Git-Junsang/SpikeSense-Edge/documents/papers/diagrams/fig1_pipeline.png

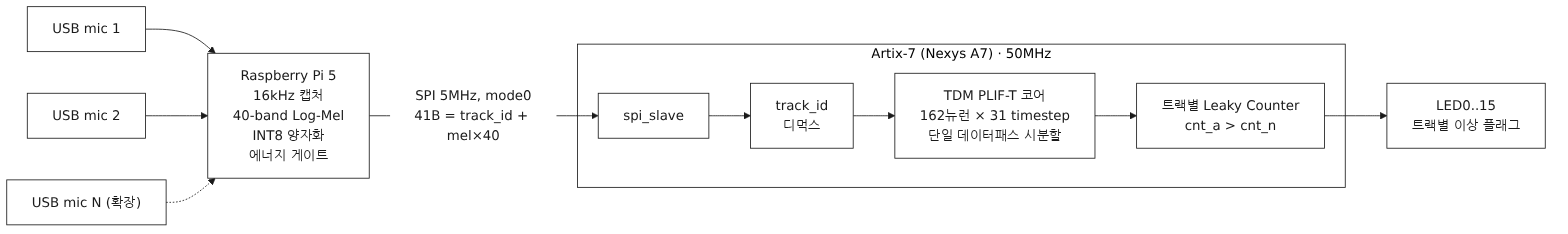
documents/papers/diagrams/fig1_pipeline.png
