Git-Junsang/SpikeSense-Edge/hardware/src/param_rom.v

// param_rom.v — 뉴런별 학습 파라미터 ROM: β(162) + V_th(162)
//
// 인덱스 구조 (neuron_idx 0~161):
//   [  0 ~ 127]: L1 (128뉴런, fc1→hidden1_lif)
//   [128 ~ 159]: L2 ( 32뉴런, fc2→hidden2_lif)
//   [160 ~ 161]: L3 (  2뉴런, fc3→output_lif)
//
// beta: Q0.8 uint8 (float_beta = beta_q/256), HW: decayed = (beta_q × mem) >> 8
// vth : INT8 양수 7~109, HW: mem_new >= {8'b0, vth}
//
// 읽기: 조합논리 (지연 없음)

module param_rom #(
    parameter N_NEURONS = 162
)(
    input  wire [7:0]           neuron_idx, // 0~161

    output wire [7:0]           beta,       // Q0.8 uint8
    output wire [7:0]           vth         // INT8 양의 정수 (unsigned 저장)
);

    reg [7:0] beta_mem [0:N_NEURONS-1];
    reg [7:0] vth_mem  [0:N_NEURONS-1];

    // hex 경로: 시뮬은 저장소 루트 기준 상대경로, 합성은 파일명만 (weight_bram.v 참조)
    initial begin
`ifdef SYNTHESIS
        $readmemh("beta.hex", beta_mem);
        $readmemh("vth.hex",  vth_mem);
`else
        $readmemh("hardware/src/weights/beta.hex", beta_mem);
        $readmemh("hardware/src/weights/vth.hex",  vth_mem);
`endif
    end

    assign beta = beta_mem[neuron_idx];
    assign vth  = vth_mem[neuron_idx];

endmodule
