Git-Junsang/SpikeSense-Edge/(commit log)

2026-05-15 software 완성, 하드웨어 다시 설계 필요
2026-05-15 software 업데이트
2026-05-18 data_sub 추가. README 추가. 현재 모델 학습까지 완료
2026-05-18 phase1, phase2 완료
2026-05-18 phase 2 tb 완료
2026-05-18 phase 3 tb 완료
2026-05-18 phase 4 tb 완료
2026-05-18 README·개발가이드.md 업데이트 — Phase 4 완료 반영
2026-05-18 계획 추가
2026-05-26 Phase 5 완료 — 듀얼채널 + SPI 인터페이스
    RTL 설계·검증이 최상위(dual_snn_top)까지 완결. tb_dual_snn_top 314/314 PASS.
    - spi_slave.v: SPI mode 0(CPOL=0,CPHA=0) 수신기
    · 41B 패킷 [channel_id(1B)][mel×40(40B)] 디코딩
    · sck/mosi/cs_n 2단 FF CDC 동기화, MSB-first 시프트
    · cs 상승 + bit_cnt==328에서 frame_rdy 펄스
    · mel_out[c*8+:8]=mel[c] 재배치 (snn_top mel_in 패킹과 일치)
    - dual_snn_top.v: spi_slave + snn_top ×2 최상위
    · channel_id(0/1)로 frame_valid 디먹스 → 채널별 독립 BRAM·막전위
    · 출력 ch0_anomaly/ch1_anomaly (LED0/LED1), ch0_busy/ch1_busy
    - constraints/nexys_a7.xdc: Nexys A7 100T 핀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
2026-05-27 Phase 6-1 — Vivado 합성·구현 플로우 + study_guide 문서화
    - hardware/fpga: create_project.tcl·build_bitstream.tcl·copy_hex.tcl 추가
    - weight_bram·param_rom: SYNTHESIS 매크로 분기로 hex 경로 처리 (합성/시뮬)
    - documents/study_guide: 23개 챕터 + 다이어그램(SVG/mmd) 추가
    - 데이터셋(data/·data_sub/) git 추적 제거 + .gitignore 정리
    - README·개발가이드.md Phase 6 반영
2026-05-27 Phase 6-2 — 다중 트랙 시분할(TDM) @50MHz
    - mt_snn_top: 단일 데이터패스(MAC·weight BRAM·param ROM·spike_mem)를 N트랙 시분할 공유, 트랙별 막전위·이상카운터만 복제
    - membrane_mem_mt(트랙별 동기읽기 BRAM, first_ts 마스킹 리셋)·anomaly_judge_mt·control_fsm_mt(track_id·ts_arr·first_ts)·clk_div2(100→50MHz)
    - mt_spi_top: clk분주 + spi_slave + channel_id=track_id 디먹스 → LED[0..15] (snn_top/dual_snn_top 동결)
    - 검증: tb_mt_snn_top 496/496(4트랙 인터리빙 bit-exact), tb_mt_spi_top 8/8(SPI 통합)
    - Vivado: create_project_mt.tcl(Top=mt_spi_top) + nexys_a7_mt.xdc(50MHz 생성클럭)
    → 합성·구현·비트스트림 완주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
2026-05-27 Phase 6 완료 — 보드 자가진단 + 문서 정합성 + src_old 제거
    - 보드 자가진단 mt_selftest_top: RPi 없이 칩 안 골든 anomaly로 출력 스파이크 62개를 자체 비교 → 실보드 PASS(LED15). create_project_selftest.tcl·nexys_a7_selftest.xdc·copy_hex_selftest.tcl·tb_mt_selftest.v 추가, mt_snn_top에 dbg_* 관찰 출력 추가
    - Phase 6-2 빌드 결과 반영: WNS +4.072ns @50MHz, LUT 2033/FF 4605/BRAM 12/DSP 1
    - 1세대 구 RTL src_old/·testbench_old/ 제거 (시분할 설계로 대체)
    - 문서 정합성: README·개발가이드·study_guide Phase 6 완료 반영, "162클럭/타임스텝"→"162뉴런(≈9,607클럭)" 정정, tb_phase2.v→phase2_tb.v, Pha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
2026-05-27 명명 통일(mult/dual·데이터셋) + 문서 위치 정합 + study_guide 다이어그램 크기 기준화
    - RTL 시분할 명명 mt_* → mult_* 전면 리네임: mult_snn_top·mult_spi_top·
    mult_selftest_top·membrane_mem_mult·control_fsm_mult·anomaly_judge_mult
    (+ tb 3종). 공용 모듈(snn_top·dual_snn_top·plift_core 등) 동결.
    시뮬 재검증: mult_snn_top 496/496, mult_spi_top 8/8, mult_selftest PASS,
    dual_snn_top 314/314.
    - Vivado/XDC: vivado_spikehw→vivado_spikehw_dual, vivado_spikehw_mt→_mult,
    nexys_a7.xdc→nexys_a7_dual.xdc, nexys_a7_mt.xdc→nexys_a7_mult.xdc,
    create_project_mt.tcl→create_project_mult.tcl. selftest 이름은 유지.
    - 데이터셋 디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
2026-05-30 Phase 7 완료 — RPi5 소프트웨어 (rpi/) + 양자화 정확도 분석
    - rpi/capture_mel.py: USB 마이크 N트랙 캡처 + Mel INT8 변환 (학습 전처리 1:1)
    - rpi/snn_infer.py: NumPy INT8 추론 (골든 벡터 RTL bit-exact PASS)
    - rpi/fpga_spi.py: SPI 드라이버 (41B 패킷, track_id, MockSpi)
    - rpi/main.py: 다중 트랙 파이프라인 (--dry-run / --from-wav / --monitor)
    - software/compare_quant.py: float32 vs INT8 양자화 정확도 비교
    (MIMII +0.33%p / DCASE -0.34%p — 양자화 손실 사실상 없음)
    - .gitignore: 데이터셋(data_dcase/mimii)·log.txt 제외, 추적되던 .pyc 제거
    - README.md: Phase 7 현황 업데이트
    - documents: 논문 초안 + study_gu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
2026-05-30 마이크 캡처: USB 마이크 네이티브 SR로 녹음 후 16kHz 리샘플링 (16k 미지원 마이크 대응)
2026-05-30 리샘플 scipy 전환(librosa numba 콜드스타트 회피) + listening 표시 + 출력 영어화
    - capture_mel: librosa.resample → scipy resample_poly (Pi에서 수십초 JIT 행 제거)
    - main: 녹음 중 '🎧 listening...' 표시(flush), 모든 런타임 출력 영어로
    - requirements: scipy 명시
2026-05-30 마이크 캡처 블로킹 수정: InputStream blocksize 고정 제거(기본0) → read(blk) 누적
    큰 blocksize(~1초치)를 stream에 고정하면 ALSA 버퍼 미충족으로 read가 영원히 블로킹.
    PortAudio 기본 주기로 받고 read(blk)가 누적하도록 변경.
    [capture_mel.py]
2026-05-30 마이크 녹음: InputStream.read → sd.rec(고정 길이) + 워치독 타임아웃
    read는 데이터 올 때까지 무한 대기라 마이크/ALSA 무응답 시 영영 안 돌아옴.
    sd.rec는 디바이스 클럭 기준 고정 길이 녹음이라 무음이라도 종료. 추가로 스레드
    타임아웃(기대길이×3+2s)으로 보호 → 무한 대기 대신 명확한 에러 출력.
2026-05-30 arecord 백엔드 + 워밍업 + 게인/단계로그 추가
    - ArecordCapture: arecord 서브프로세스 녹음(PortAudio 무한대기 회피), plughw 자동탐지, subprocess timeout, peak/rms 로그
    - warmup(): librosa 첫 호출(~15s) 비용을 시작 시점으로 이동
    - --alsa/--gain/--dur/-v 인자, 백엔드 선택(_make_capture)
    - MicCapture에도 gain/verbose
2026-05-30 Phase 8 — RPi↔FPGA SPI 통합 테스트 도구 + 프로토콜 검증 반영
    - rpi/hw_test.py: SPI 통합 테스트(wiring/led/sweep) — LED 관찰로 링크·디먹스·이상판정 검증
    - software/make_hw_test_vectors.py + hw_{anomaly,normal}_mel.npy:
    HW 이상판정(스파이크 Leaky Counter cnt_a>cnt_n)을 확실히 켜고/끄는 전용 벡터
    (골든 벡터는 둘 다 LED 못 켬 — 막전위 argmax와 규칙 다름)
    - 멀티에이전트 적대 검증 반영:
    · SPI 10→5MHz (검증 tb_mult_spi_top 일치, 50MHz 동기화 마진 확보)
    · 프레임 간격 500µs→1ms (frame_valid는 S_IDLE에서만 수용 → busy 중 드롭 방지)
    · 패킷 바이트순서·track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
    [fpga_spi.py, hw_test.py, main.py]
2026-05-30 Mel을 순수 numpy로 재구현 — librosa/numba 의존 제거 (Python 3.13 대응)
    문제: RPi5 venv가 Python 3.13인데 numba가 미지원 → librosa 설치 불가 →
    main.py FPGA/실시간 경로에서 ModuleNotFoundError.
    해결: librosa.melspectrogram + power_to_db(ref=max)를 numpy STFT(periodic Hann,
    center/constant-pad) + Slaney 필터뱅크(.npy 동봉)로 재현.
    검증: MIMII 12파일 int8 max|diff|=1, mismatch 0.001%, 11/12 bit-exact.
    부수효과: librosa numba JIT ~15초 콜드스타트 제거. warmup도 즉시.
    - hardware/src/weights/mel_filter_40_1024.npy: librosa Slaney 필터뱅크(40×513) 동봉
    - wav_to_segments 리샘플도 librosa→scipy resampl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
2026-05-30 에너지 게이트 추가 — 정적(도메인 밖) 입력 오탐 억제
    문제: per-buffer 정규화가 진폭 정보를 없애 조용한 ambient 노이즈를 풀스케일로
    증폭 → 도메인 밖 입력이 이상(LED ON)으로 오판.
    해결: 원시 파형 RMS < --silence-rms(기본 0.01)면 '무음'으로 보고 normal 벡터 전송
    → LED off 유지. read_segments가 (tid, seg, rms) 반환하도록 확장.
    시끄러운 산업 현장에선 RMS가 항상 높아 게이트 미동작(무해).
    - capture_mel: rms_of() + 두 백엔드 read_segments에 rms 부착
    - main: 게이트 분기, --silence-rms/--no-gate 인자, 결과에 rms 표시
2026-05-30 RMS 미터(--meter) 추가 + 게이트 기본 0.01→0.003 하향
    - --meter: 소리 내며 rms/dBFS 라이브 관찰 → --silence-rms 컷라인 보정용 (추론/SPI 없음)
    - 기본 --silence-rms 0.01→0.003 (53dB 작은 음원도 통과하도록 하향, 현장 보정은 --meter로)
    - 마이크 증폭은 ALSA(amixer) 권장 — 소프트 --gain은 게이트 민감도 불변임을 미터에 명시
2026-05-30 게이트 기본 0.003→0.002 (작은 음원 -50dBFS 통과) + 미터 안내 정정
    이 USB 마이크는 ALSA 게인 컨트롤이 없음. 하지만 모델이 스케일 불변이라 증폭 불필요 —
    게이트 컷라인만 목표소리(-50dBFS≈0.0032) 아래·정적(~-61dBFS) 위로 두면 됨. 기본 0.002(-54dBFS).
2026-05-30 게이트 버그 수정(normal_vec 누적 제거) + LED 예측 섀도우 카운터
    핵심 버그: 정적마다 normal 벡터를 전송 → FPGA cnt_n이 누적·포화 → 이후 진짜 이상이
    와도 cnt_a>cnt_n을 못 넘겨 LED가 영영 안 켜짐.
    수정: 정적이면 아무것도 전송하지 않음(skip) → 카운터 비오염.
    추가: snn_infer.LeakyJudge — FPGA anomaly_judge_mult와 동일한 트랙별 Leaky Counter 섀도우.
    --monitor가 cnt_a/cnt_n + LED 예측을 표시 → 보드 LED가 켜질지 터미널로 확인 가능
    (CPU_RESETN 직후 시작 시 보드와 정렬). 도메인 문제 vs 코드 문제 구분 도구.
    [main.py, snn_infer.py]
2026-06-01 전력 SAIF용 자극 전용 tb 추가 (tb_mult_spi_power) + 가이드 정정
    Post-Impl Timing Sim 실패 원인: tb_mult_spi_top이 내부 신호(busy, u_mem.mem)를
    참조 → 플랫 네트리스트에 없어 elaborate 실패. 자극 전용 tb(내부 참조·hex 없음,
    의사난수 mel로 SPI 인가)는 타이밍 네트리스트에서 동작. iverilog 동작 확인(24프레임).
    MEASUREMENT_GUIDE 전력 절차를 이 tb 기준으로 갱신(strip_path 등).
2026-06-01 전력 tb 자극 축소 (N_TS 6→2, 대기 300→250us) — timing 시뮬 ~2.5ms로 단축
2026-06-07 진행상황 문서화 — PROGRESS.md 추가 + README Phase 8 완료/Phase 9 데모 방침
    - documents/PROGRESS.md: Phase 0~9 현황·기술 결정·도메인 한계·데모 방침(재녹음/재학습 보류, 조용한 환경 시연) 정리
    - README: Phase 8 ✅ 완료(실보드 sweep 10채널·라이브 마이크 LED), Phase 9 ▶ 진행(현 모델 데모), '알려진 한계-도메인 불일치' 절 추가, 상단 현황·전력 0.124W 반영
    - .gitignore: Synology @eaDir/ 무시
2026-06-07 문서 정합성: LUT 2,033→2,007 통일 (논문/placed 리포트 기준)
    README·PROGRESS·study_guide의 LUT 수치를 논문 및 실제 구현 후(placed) 리포트값
    2,007로 통일. WNS 표기도 +4.072→+4.07로 논문과 일치.
2026-06-13 발표자료/포스터 자산 정리 + RTL 블록 다이어그램 추가
    - documents/presentation/ 신설: 발표자료(v1·v1-1·v2)·포스터(pdf/pptx)·
    Pretendard 폰트·RTL 다이어그램
    - RTL 블록 다이어그램(각진 사각형·직각 선, SVG): mult_spi_top, mult_snn_top
    + mult_snn_top PPT 컬러판, 생성 스크립트(gen_rtl_diagrams.py / gen_rtl_snn_ppt.py)
    - documents/papers/diagrams/ 로 파이프라인·네트워크 그림 이동
    - software: evaluate_dcase·plot_metrics·make_excel_template·metrics_template 추가, train.py 갱신
    - 논문 docx/pdf 갱신, Thumbs.db·Office 임시파일 .gitignore 처리
    [metrics_template.xlsx]
2026-06-15 실보드 데모 추가 — 2트랙 OLED+LED (Enter 스텝)
    RTL(신규, 기존 동결 유지):
    - anomaly_judge_seg.v: 세그먼트(31ts) 단위 스파이크 다수결 판정
    - demo_snn_top.v / demo_spi_top.v: mult 클론 + seg 판정기 (매 세그먼트 LED 토글)
    - tb_demo_spi_top.v: 사용자 시퀀스 재현 검증 PASS=8/FAIL=0
    - nexys_a7_demo.xdc, golden/hw_*_mel.hex (RTL tb용)
    RPi:
    - demo.py: Enter마다 2트랙 SPI 전송 + numpy 추론
    - oled_display.py: 1.3" I2C OLED(SH1106) 정상/이상 표시
    - requirements.txt: luma.oled 추가
    [anomaly_judge_seg.v, demo.py, demo_snn_top.v, demo_spi_top.v, nexys_a7_demo.xdc, oled_display.py, tb_demo_spi_top.v]
2026-06-15 nexys_a7_demo.xdc: QSPI 플래시 부팅 설정 추가
    CFGBVS/CONFIG_VOLTAGE 누락 시 JTAG은 되나 플래시 부팅이 실패하는 문제 수정.
    SPI_BUSWIDTH/CONFIGRATE/UNUSEDPIN도 명시.
    [nexys_a7_demo.xdc]
2026-06-15 demo.py: step4를 두 트랙 모두 이상으로 변경
    시퀀스 track1 마지막 정상→이상 (step4 = 트랙0·트랙1 둘 다 ANOMALY).
2026-07-01 문서·개발가이드 로컬 전환 + README 최신화
    - documents/(발표자료·논문·학습자료) GitHub에서 제거 → 로컬 전용(.gitignore)
    - 개발가이드.md GitHub에서 제거 → 로컬 유지(.gitignore)
    - README: Phase 9 실보드 2트랙 데모 반영, 제거된 문서 링크 정리
2026-07-01 README 영문판 메인화 + 한글판 분리(README.ko.md)
    - README.md: 영문판으로 전환(GitHub 기본 노출), 상단 언어 네비(English | 한국어)
    - README.ko.md: 한글판 신규, 인용구(>) 줄바꿈 <br>로 복원(린터 공백제거 대응)
    - Phase 9 데모 반영 유지, 한계 섹션 앵커 링크 연결
2026-07-08 README 수정
2026-07-13 주석 정리: 이모지·장식 제거, 간결하게 다듬기
